Bledixon/dpp_documentation/dpp_documentation/Making-off/IMG-20221216-WA0001.jpeg

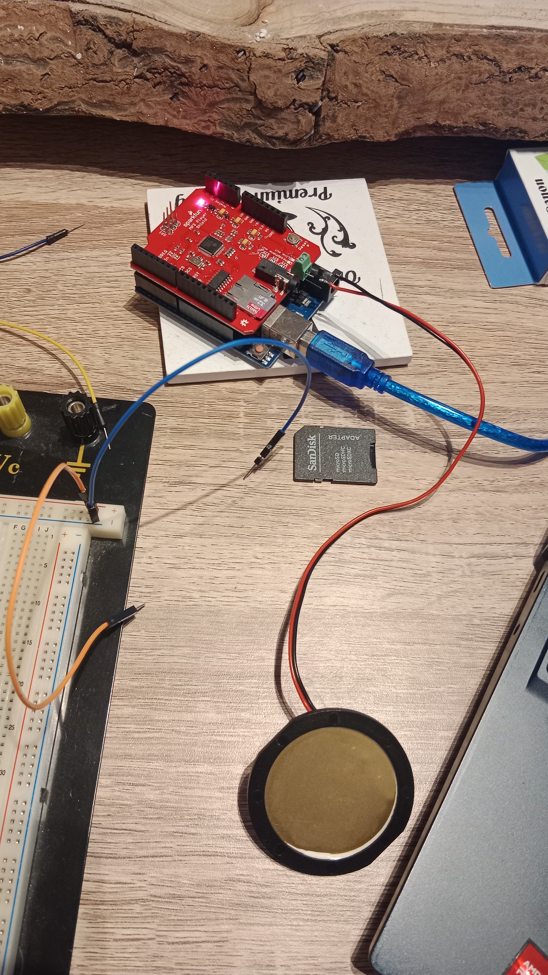
dpp_documentation/Making-off/IMG-20221216-WA0001.jpeg
