Bledixon/dpp_documentation/dpp_documentation/Making-off/IMG-20230106-WA0000.jpeg

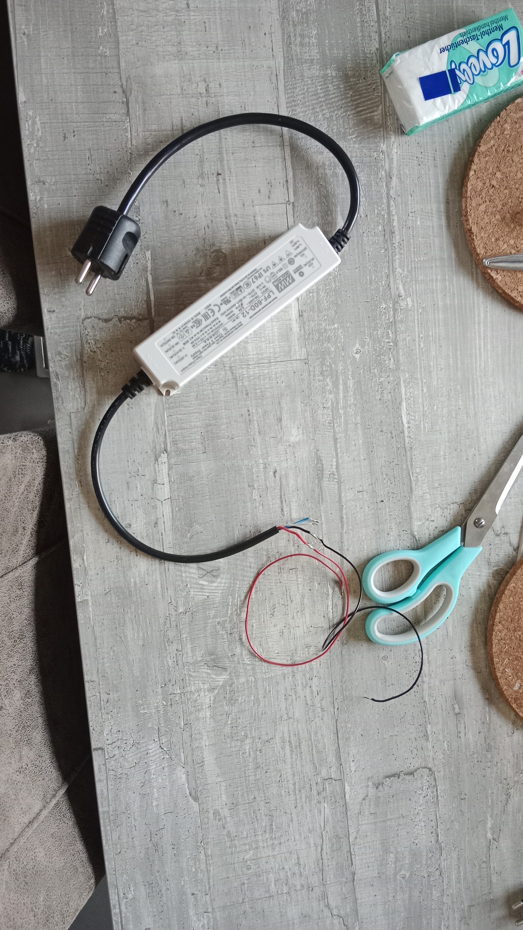
dpp_documentation/Making-off/IMG-20230106-WA0000.jpeg
