Bledixon/dpp_documentation/dpp_documentation/Making-off/IMG-20230108-WA0005.jpeg

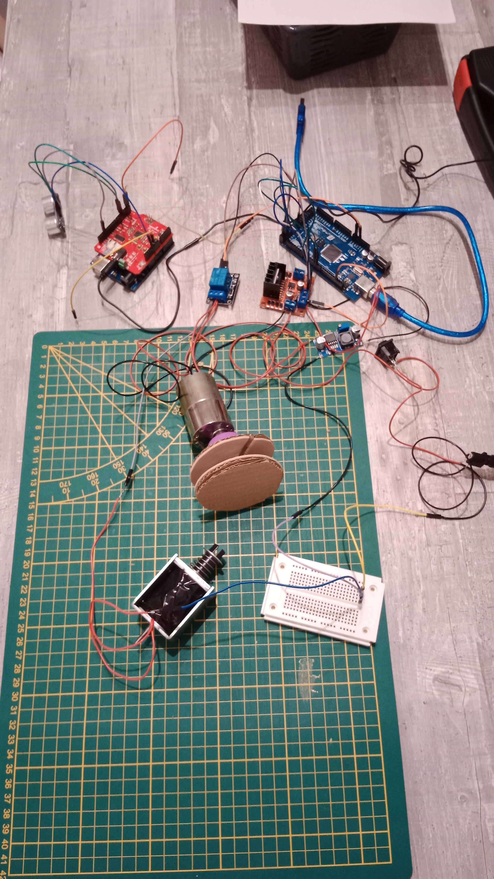
dpp_documentation/Making-off/IMG-20230108-WA0005.jpeg
