Bledixon/dpp_documentation/dpp_documentation/Making-off/IMG_20221216_094540.jpg

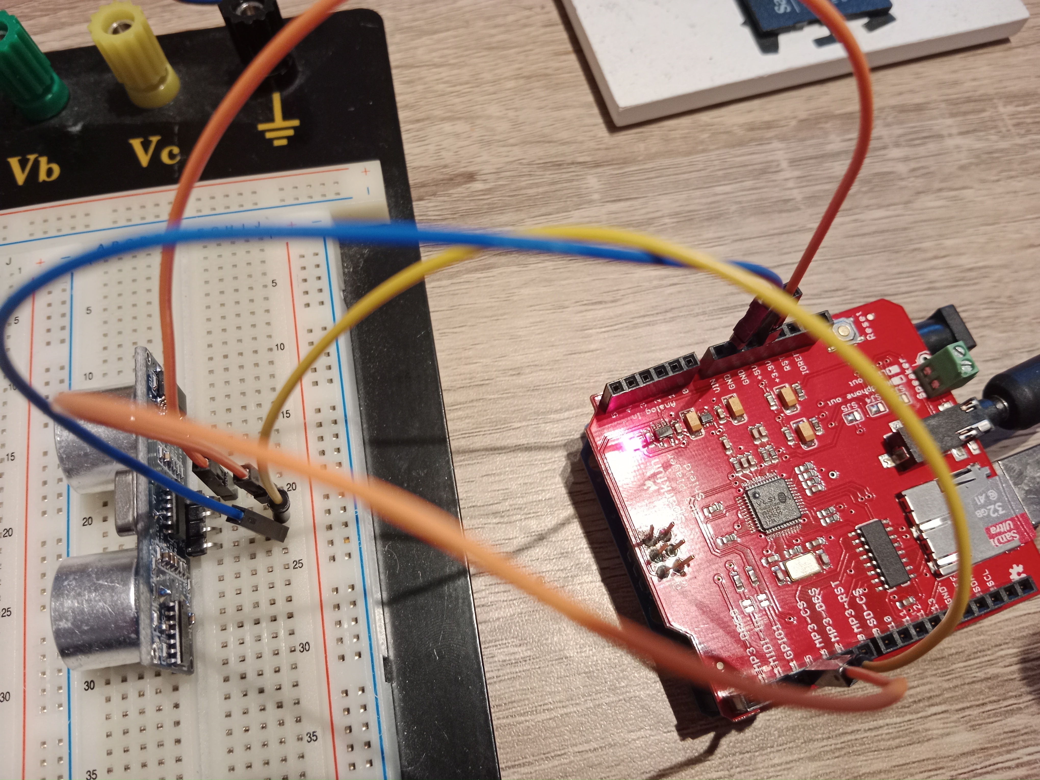
dpp_documentation/Making-off/IMG_20221216_094540.jpg
