Bledixon/dpp_documentation/dpp_documentation/Making-off/IMG_20221220_110551.jpg

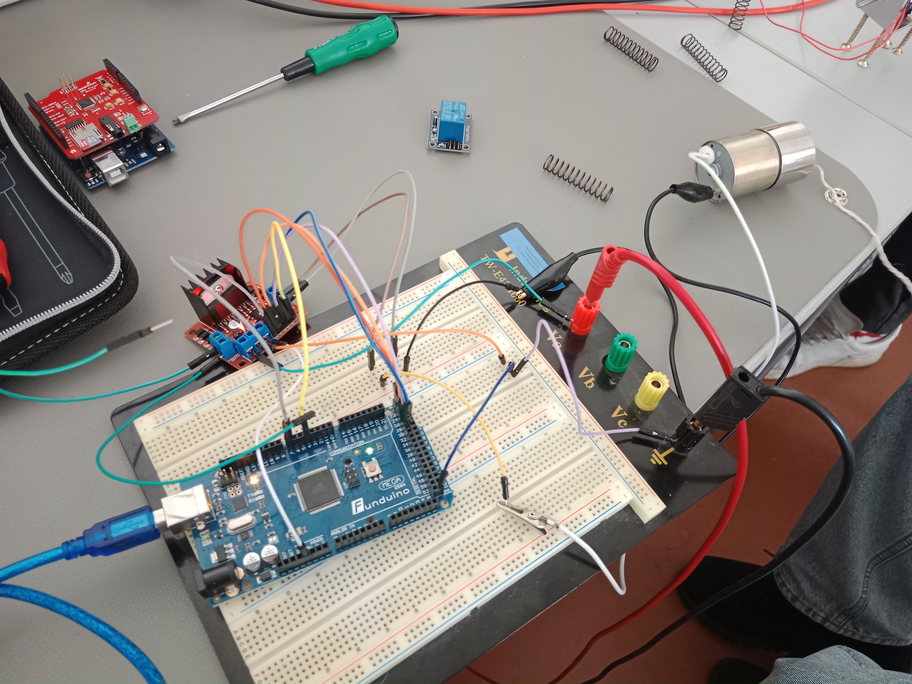
dpp_documentation/Making-off/IMG_20221220_110551.jpg
