Bledixon/dpp_documentation/dpp_documentation/Making-off/IMG_20221220_112602.jpg

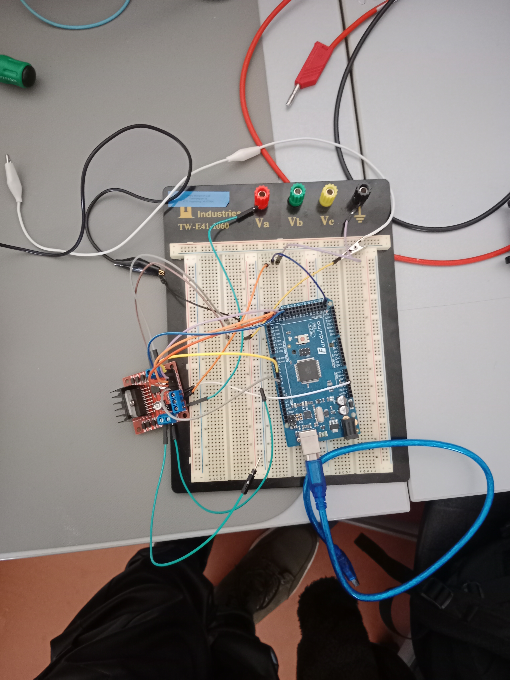
dpp_documentation/Making-off/IMG_20221220_112602.jpg
