Bledixon/dpp_documentation/dpp_documentation/Making-off/IMG_20230105_161637.jpg

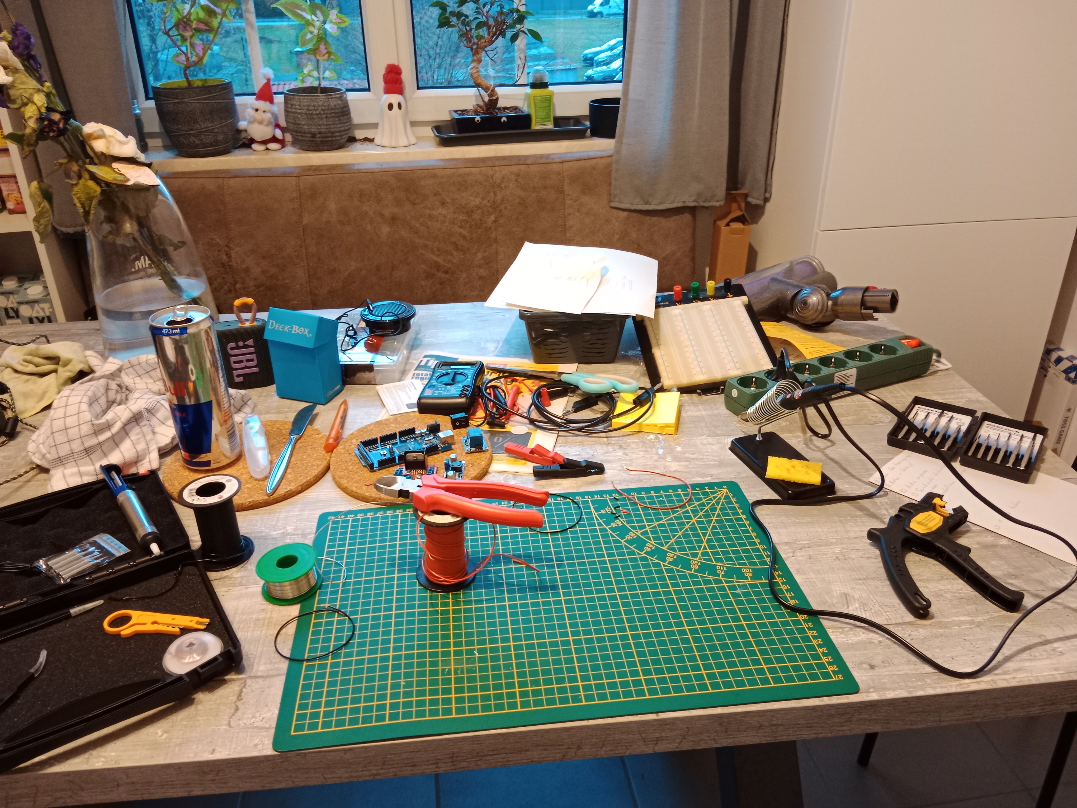
dpp_documentation/Making-off/IMG_20230105_161637.jpg
