Bledixon/dpp_documentation/dpp_documentation/Making-off/IMG_20230105_161641.jpg

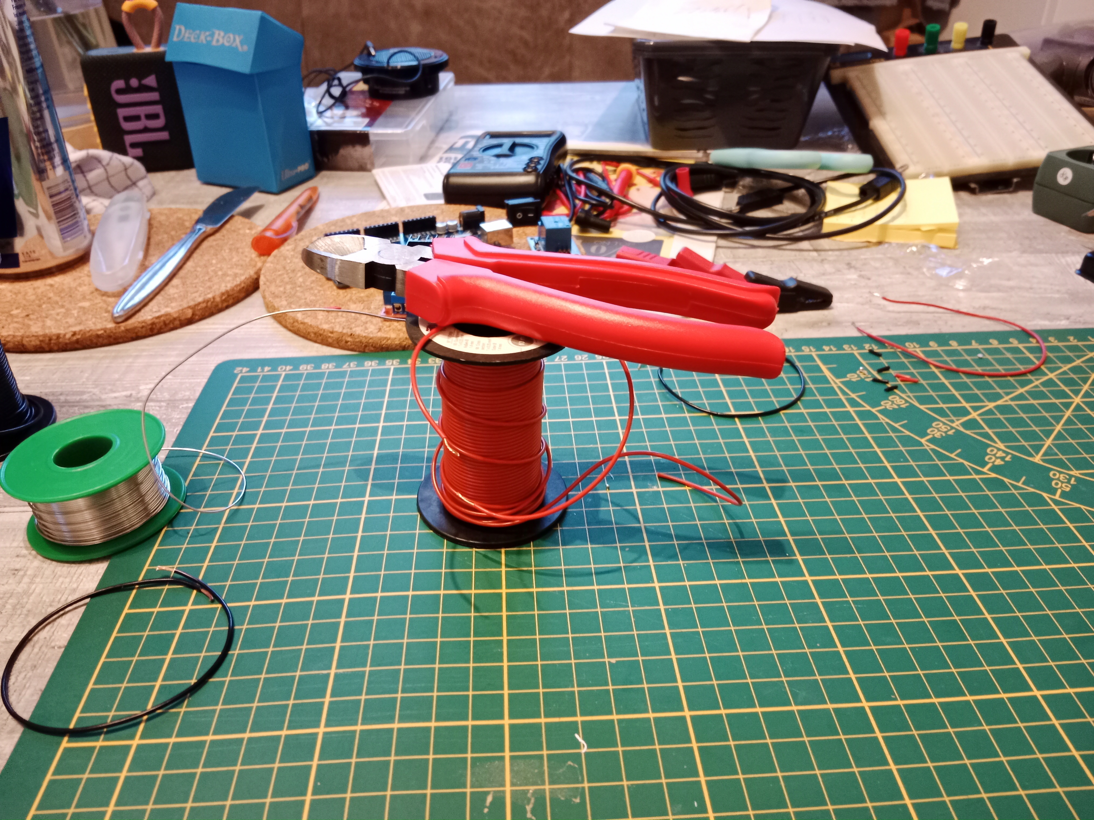
dpp_documentation/Making-off/IMG_20230105_161641.jpg
