Bledixon/dpp_documentation/dpp_documentation/Making-off/IMG_20230105_170427.jpg

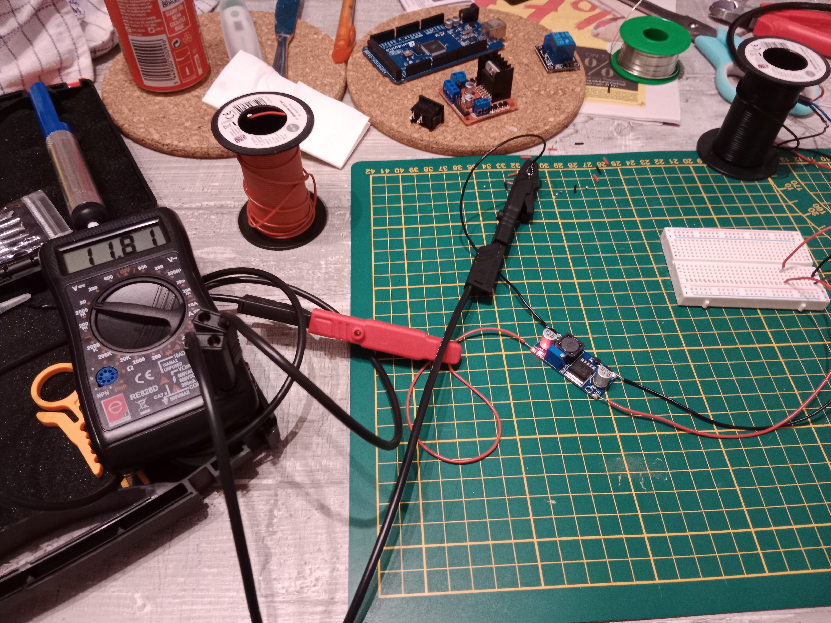
dpp_documentation/Making-off/IMG_20230105_170427.jpg
