Bledixon/dpp_documentation/dpp_documentation/Making-off/IMG_20230106_132527.jpg

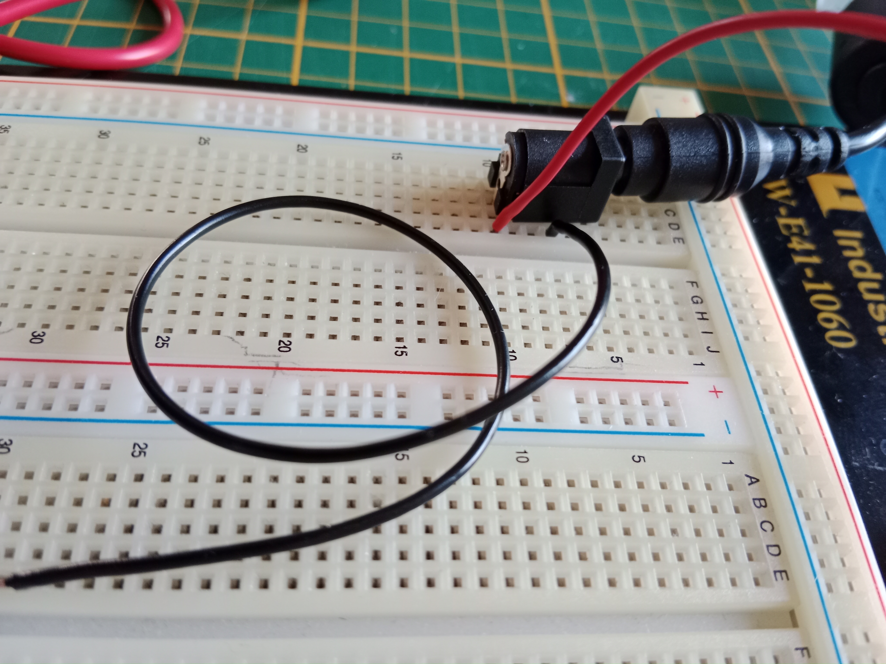
dpp_documentation/Making-off/IMG_20230106_132527.jpg
