Bledixon/dpp_documentation/dpp_documentation/Making-off/IMG_20230106_132530.jpg

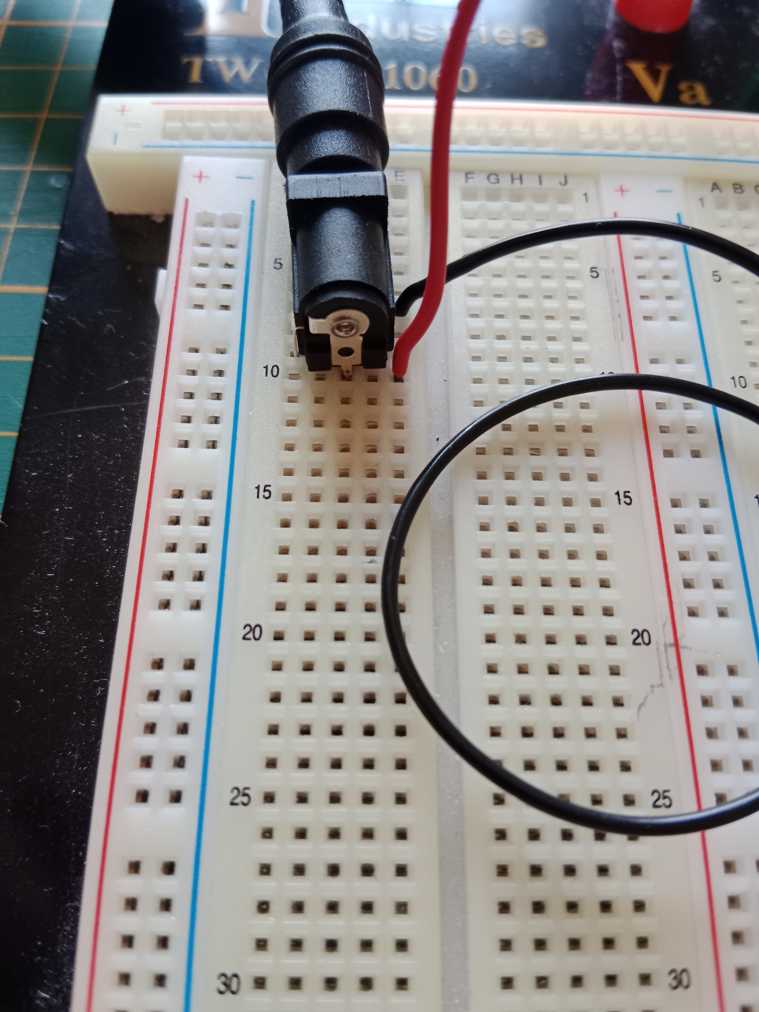
dpp_documentation/Making-off/IMG_20230106_132530.jpg
