Bledixon/dpp_documentation/dpp_documentation/Making-off/IMG_20230107_155636.jpg

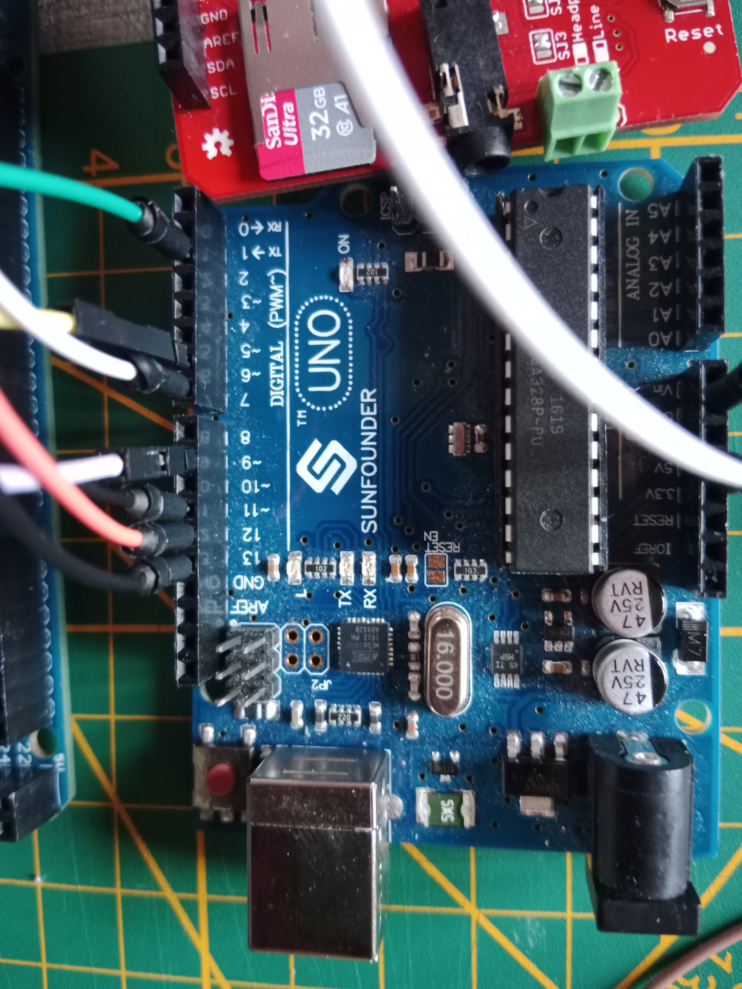
dpp_documentation/Making-off/IMG_20230107_155636.jpg
