Bledixon/dpp_documentation/dpp_documentation/Making-off/IMG_20230107_155641.jpg

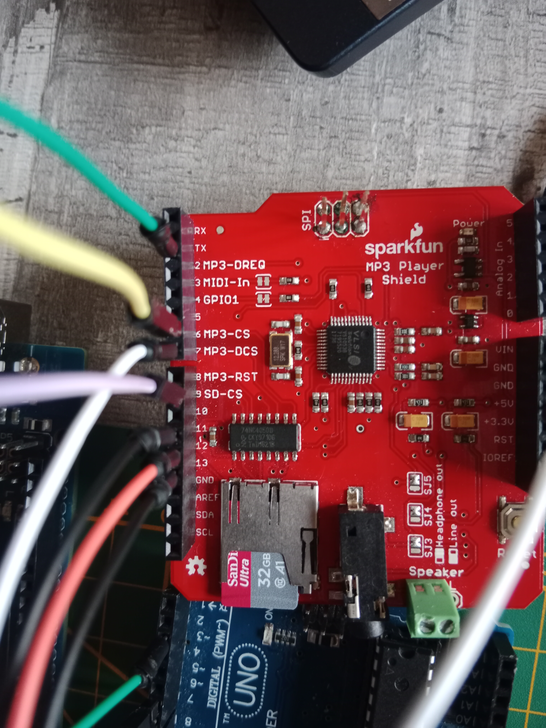
dpp_documentation/Making-off/IMG_20230107_155641.jpg
