Bledixon/dpp_documentation/dpp_documentation/Making-off/IMG_20230108_140050.jpg

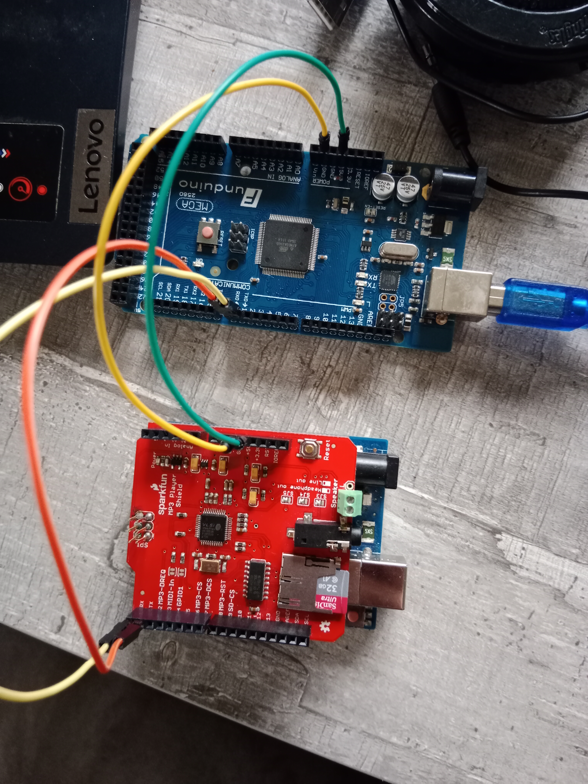
dpp_documentation/Making-off/IMG_20230108_140050.jpg
