Bledixon/dpp_documentation/dpp_documentation/Making-off/IMG_20230108_150041.jpg

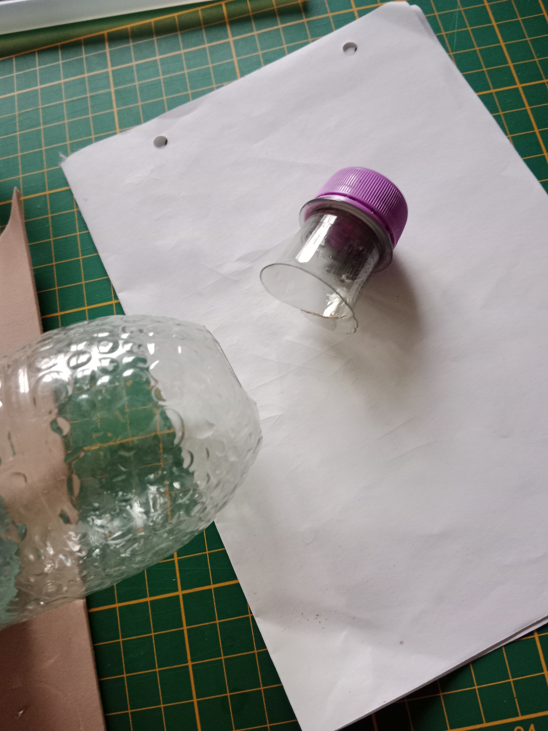
dpp_documentation/Making-off/IMG_20230108_150041.jpg
