Bledixon/dpp_documentation/dpp_documentation/Making-off/IMG_20230114_114750.jpg

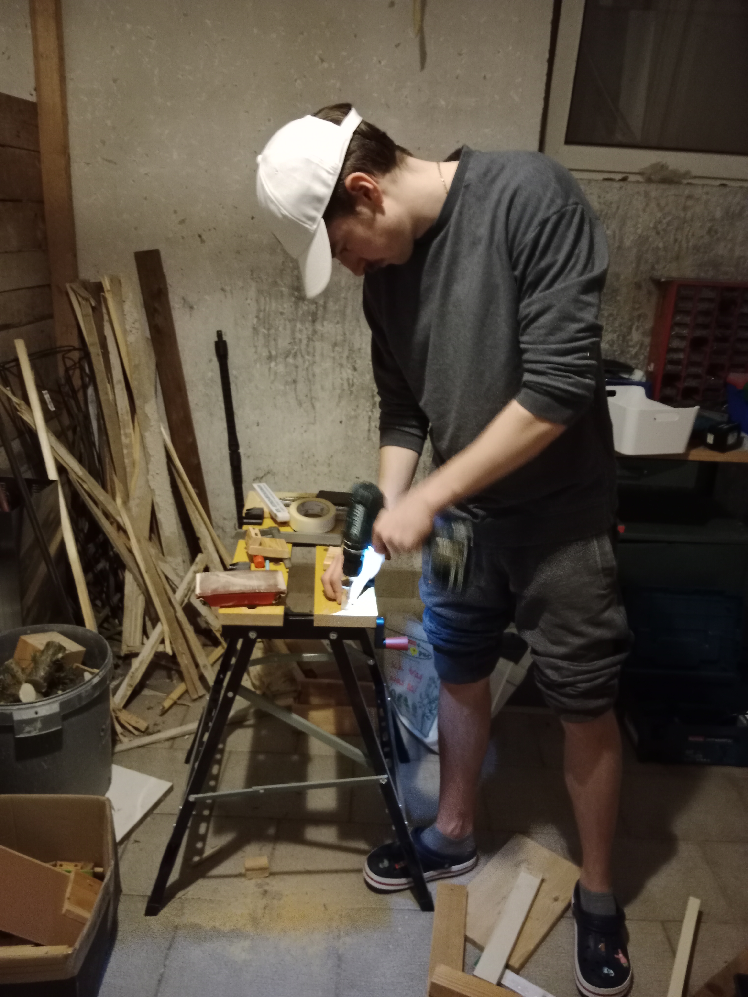
dpp_documentation/Making-off/IMG_20230114_114750.jpg
