Bledixon/dpp_documentation/dpp_documentation/Making-off/IMG_20230114_114752.jpg

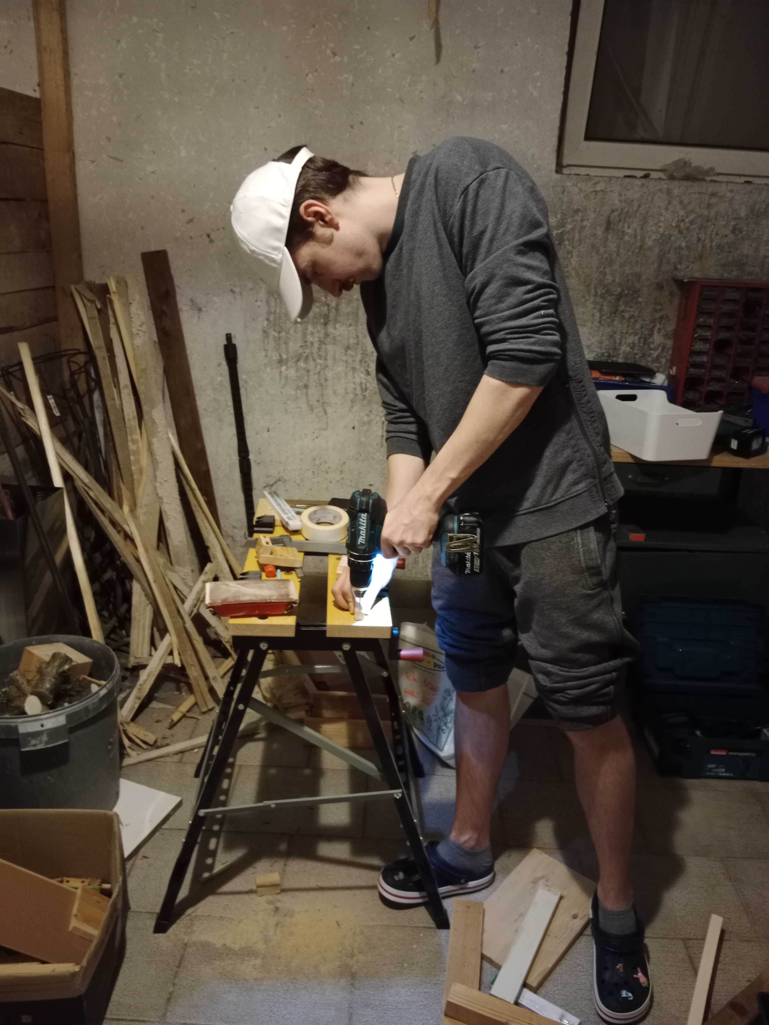
dpp_documentation/Making-off/IMG_20230114_114752.jpg
