Bledixon/dpp_documentation/dpp_documentation/Making-off/IMG_20230114_164149.jpg

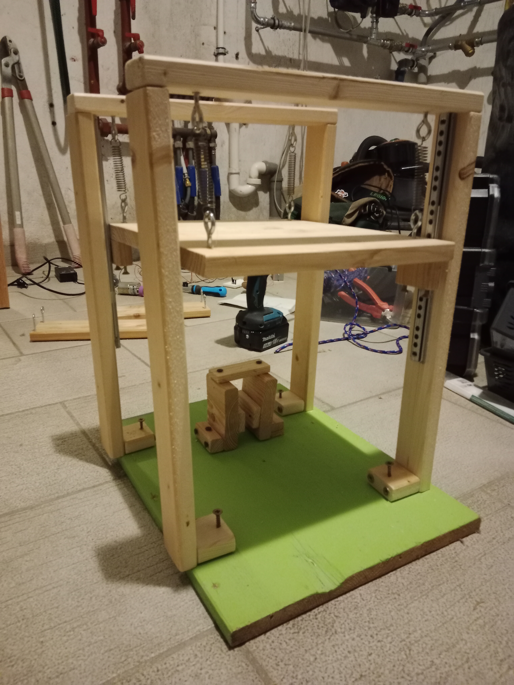
dpp_documentation/Making-off/IMG_20230114_164149.jpg
