Bledixon/dpp_documentation/dpp_documentation/Making-off/IMG_20230115_130613.jpg

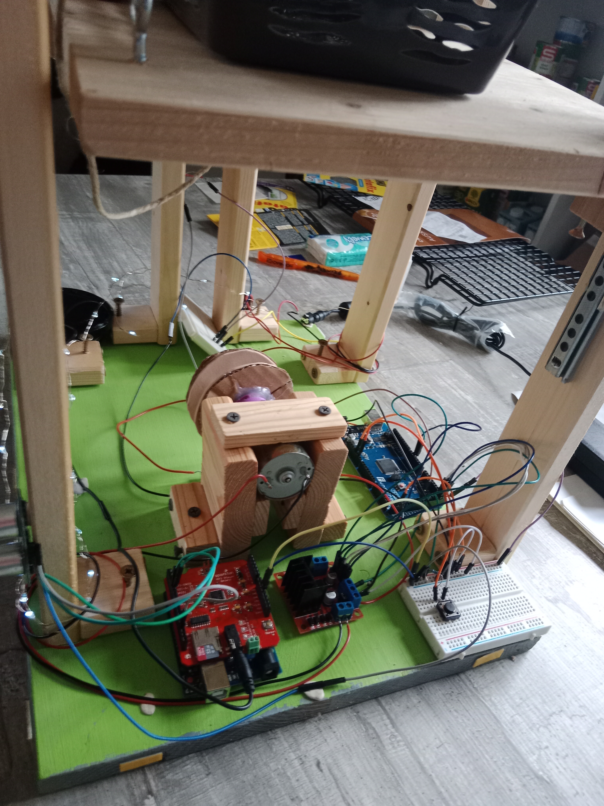
dpp_documentation/Making-off/IMG_20230115_130613.jpg
