Bledixon/dpp_documentation/dpp_documentation/Making-off/IMG_20230117_102843.jpg

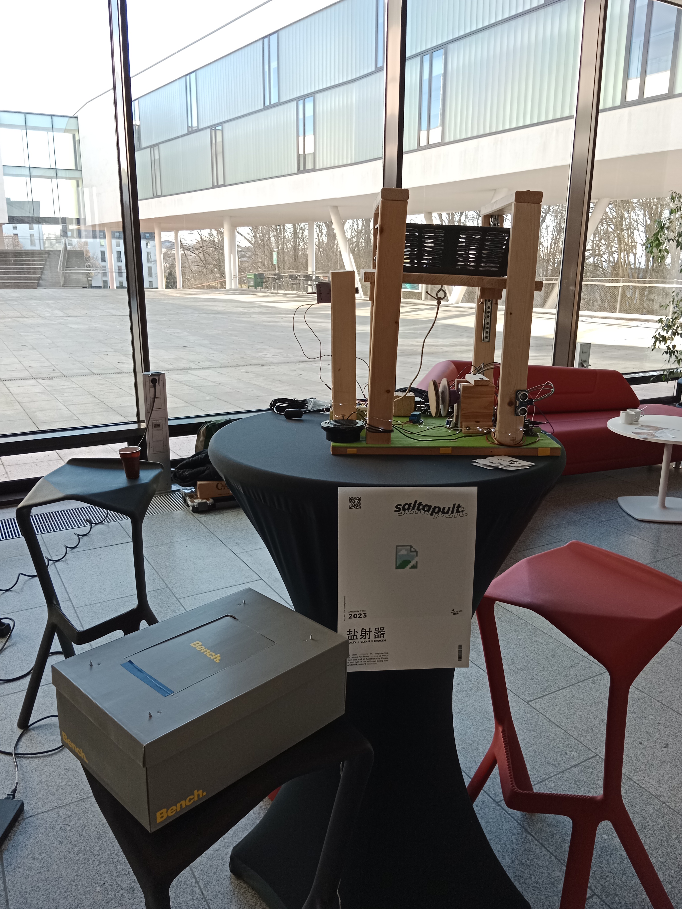
dpp_documentation/Making-off/IMG_20230117_102843.jpg
