Bledixon/dpp_documentation/dpp_documentation/Making-off/IMG_20230117_102852.jpg

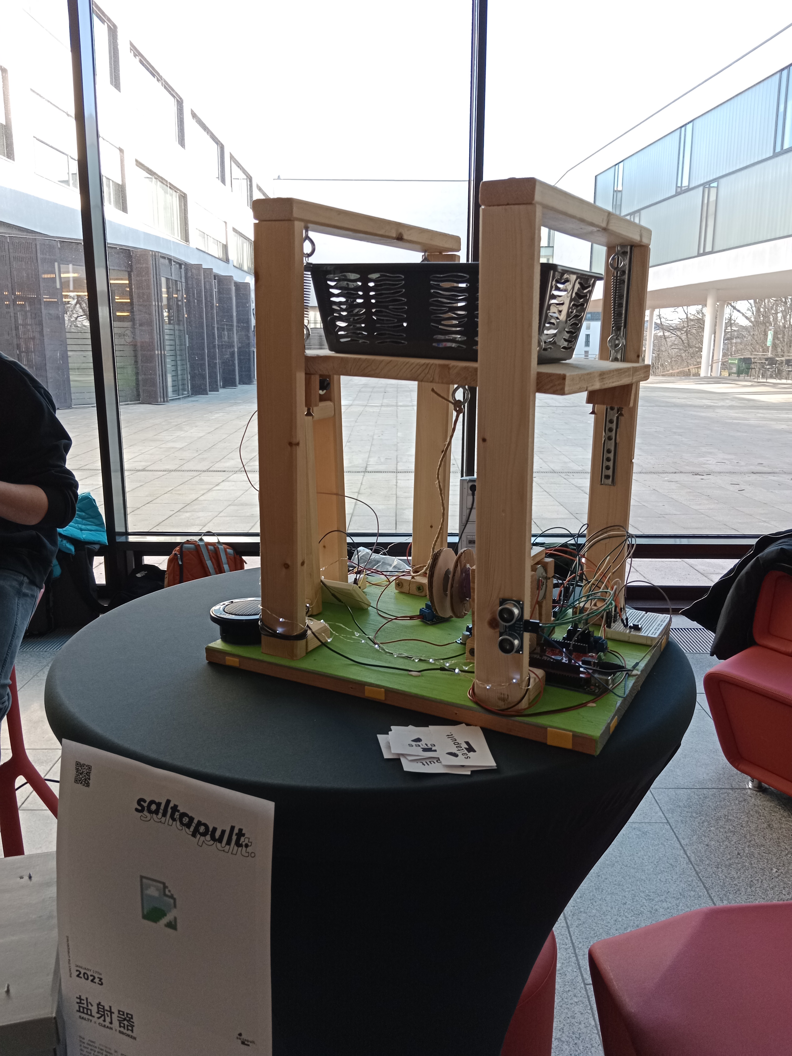
dpp_documentation/Making-off/IMG_20230117_102852.jpg
