Bledixon/dpp_documentation/dpp_documentation/Making-off/IMG_20230117_102855.jpg

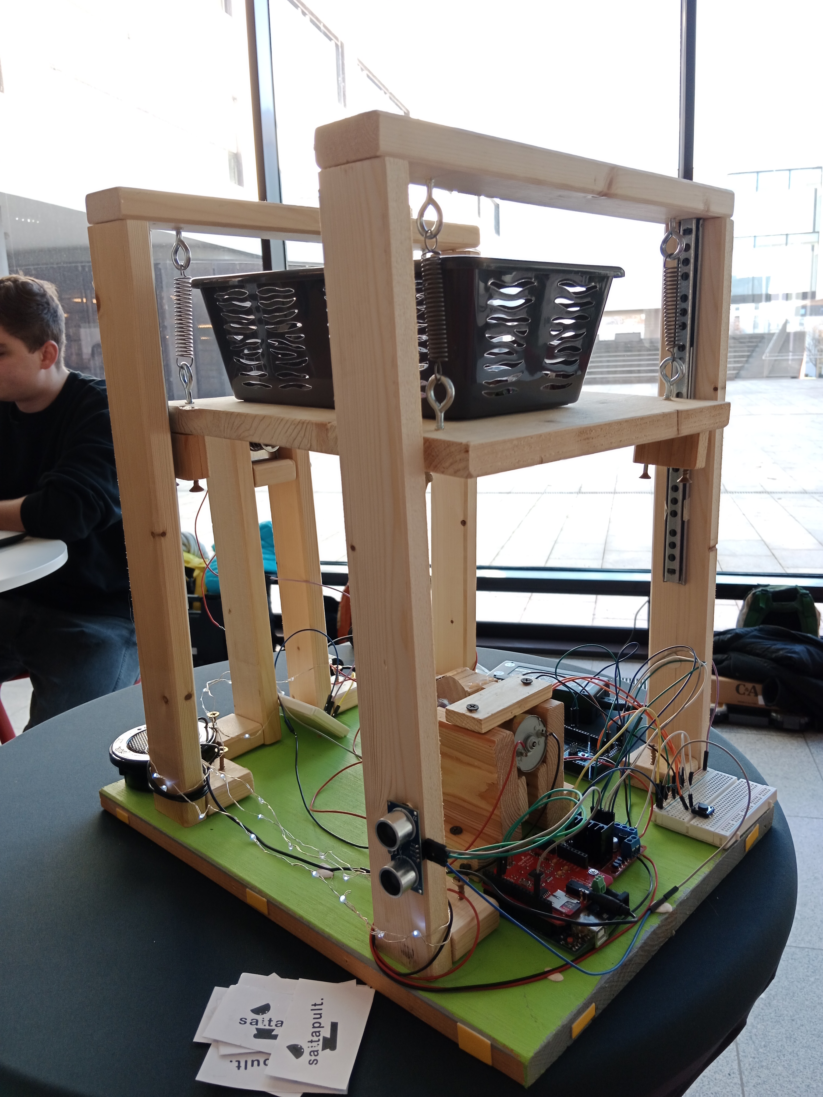
dpp_documentation/Making-off/IMG_20230117_102855.jpg
