Bledixon/dpp_documentation/dpp_documentation/Making-off/IMG_20230117_102914.jpg

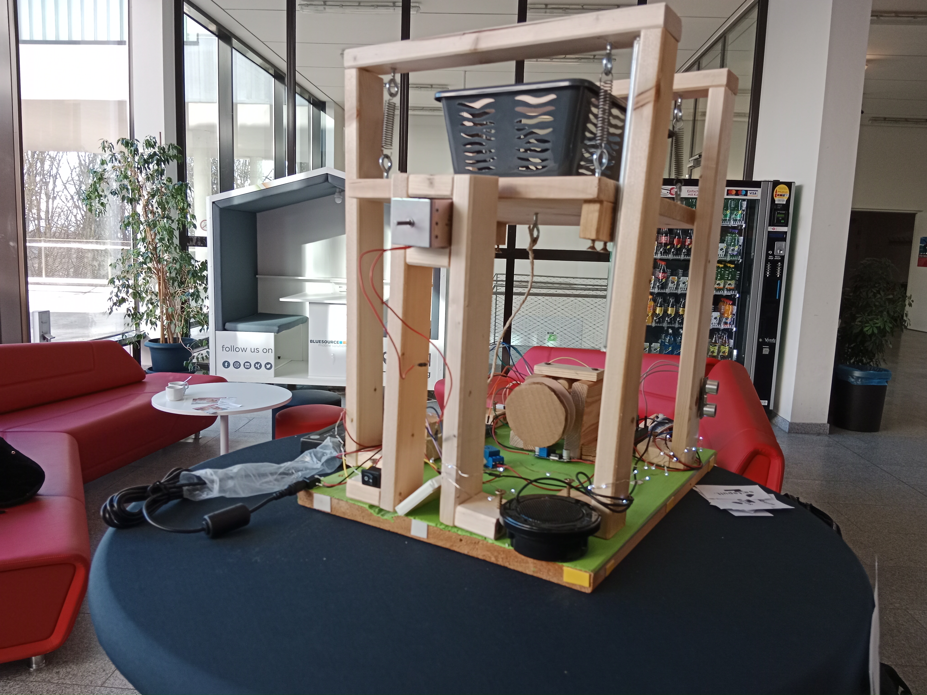
dpp_documentation/Making-off/IMG_20230117_102914.jpg
