Bledixon/dpp_documentation/dpp_documentation/Making-off/IMG_20230117_131549.jpg

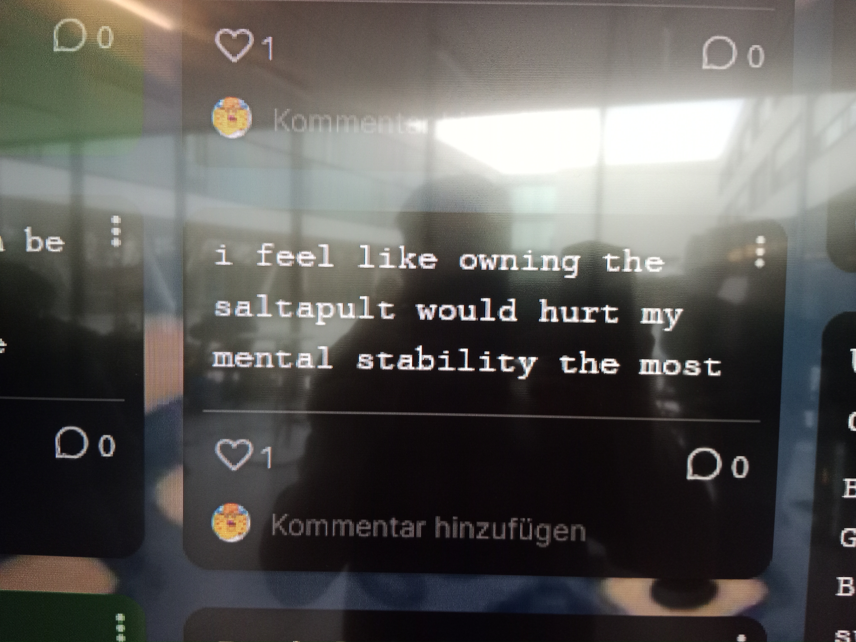
dpp_documentation/Making-off/IMG_20230117_131549.jpg
