Bledixon/dpp_documentation/dpp_documentation/Making-off/IMG_20230120_100951.jpg

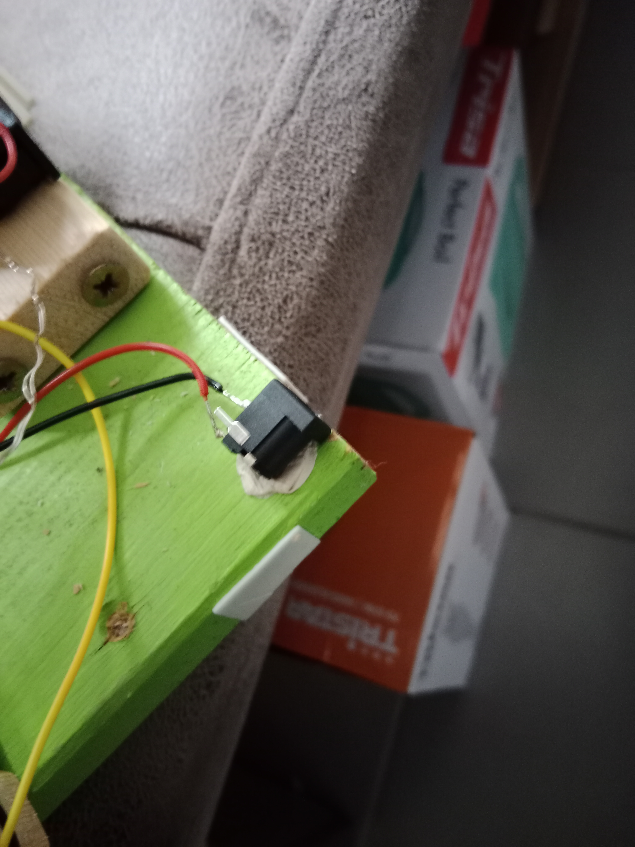
dpp_documentation/Making-off/IMG_20230120_100951.jpg
