Bledixon/dpp_documentation/dpp_documentation/Making-off/IMG_20230120_153654.jpg

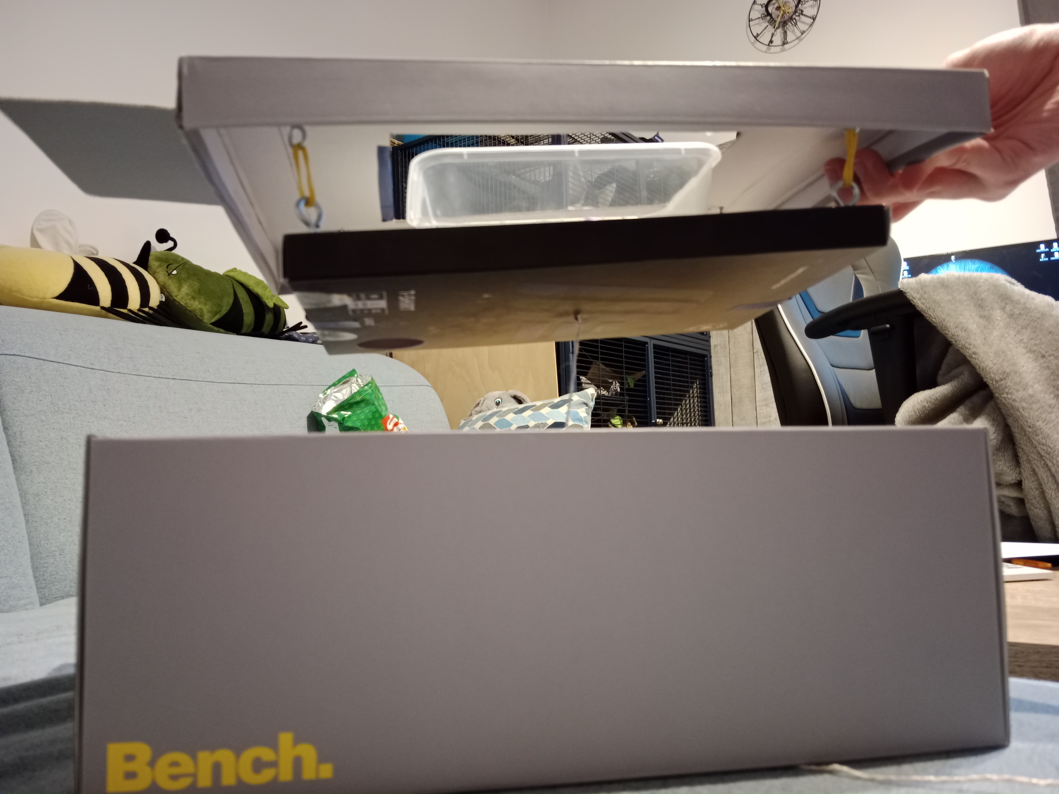
dpp_documentation/Making-off/IMG_20230120_153654.jpg
