Bledixon/dpp_documentation/dpp_documentation/Making-off/IMG_20230120_153704.jpg

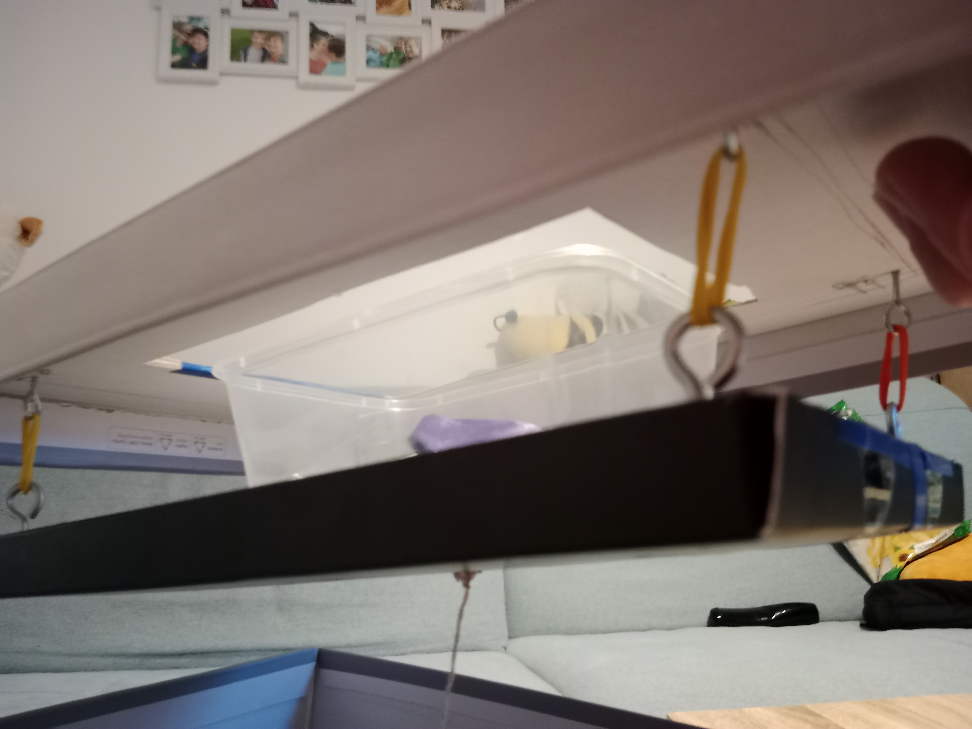
dpp_documentation/Making-off/IMG_20230120_153704.jpg
