Bledixon/dpp_documentation/(commit log)

2023-01-20 Update final prototype
    Es fehlt noch das beschreiben des Notfallplans und wie die Box zusammen gebaut wurde
2023-01-20 material list pic
2023-01-20 Added material list to docu
2023-01-20 Add 1. prototype picture
2023-01-22 Added wire plan to protocoll
2023-01-22 Update wireplan
2023-01-23 Adding first steps for Fixating the motor section
2023-01-23 Adding motor structure file
2023-01-23 Uploading Torque Test
